obono/ATtiny85LED2048/doc/schematic.png

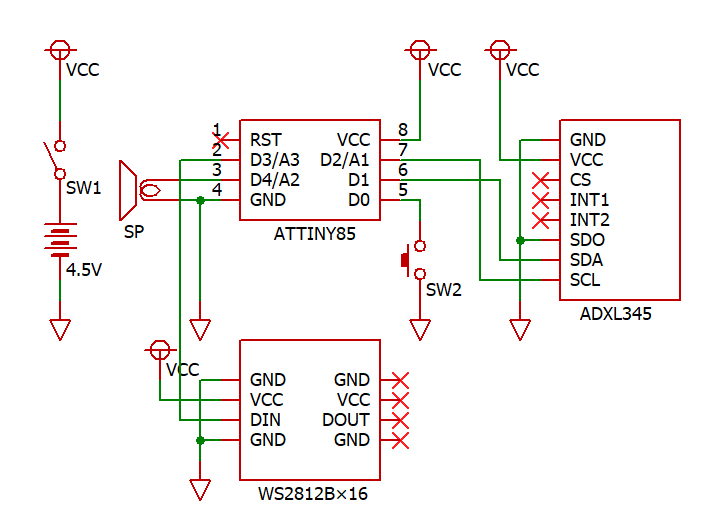
doc/schematic.png
