obono/ATtiny85LED2048/(commit log)

2025-03-25 :+1: Calibration
2025-04-12 :+1: Brightness adjustment by a button
2025-04-24 :+1: Tiny modification for calibration
